LeQcho/WIPTally/S2Mini/COMMENCER-ICI.md

# Tally Atelier 1.7.0 — démarrer ici

Double-cliquer sur **Tally Atelier.app** (Mac), **Lancer-Tally.command** (Terminal Mac) ou **Lancer-Tally.bat** (Windows). Python 3 et Internet sont nécessaires au premier lancement pour installer les dépendances de flash ; les firmwares sont déjà compilés.

## Choisir le profil

- **Master** : S2 Mini, connexion Wi-Fi à l’ATEM. Renseigner le réseau, son mot de passe, l’adresse ATEM et la luminosité de départ.
- **Récepteur** : S2 Mini, choisir le numéro de caméra et les LED. Liaison ESP-NOW au master.
- **Tally Sony** : **LOLIN C3 Mini**, voyant REC autonome en Bluetooth LE pour Sony A7 IV. La S2 Mini n’a pas de Bluetooth et ne convient pas à ce profil.

Renseigner les réglages, brancher une seule carte compatible, puis utiliser **Vérifier la préparation sans flasher** ou le bouton de flash. Le type de puce est vérifié avant écriture. Après vérification, la carte reçoit sa commande de redémarrage automatique. Les profils Sony et ATEM ont des binaires distincts.

Le profil Sony est un **prototype à valider sur caméra**. Voir [SONY.md](SONY.md) pour le câblage GPIO4, l’appairage et les essais REC/STOP. Il indique rouge pour REC confirmé, éteint pour arrêt confirmé, bleu clignotant pour état inconnu ou liaison perdue.

Ce paquet ne contient aucune partition de réglages Wi-Fi personnels. Utiliser l’interface pour préparer les cartes. Les anciens scripts de flash ATEM restent disponibles pour les usages avancés ; sans partition personnelle, ils conservent les réglages NVS existants.

[Guide de l’application](APPLICATION.md) · [Guide ATEM](README.fr.md) · [LED RGB ATEM](LED-RGB.md) · [Sony REC](SONY.md)

Le [bouton de luminosité du master](BOUTON-LUMINOSITE.md) fait passer tous les récepteurs WS2812 entre 25, 50, 75 et 100 %. Pour la mise à jour 1.5, flasher les récepteurs avant le master.

La version **1.7** affiche quatre pages sur l’[OLED SSD1306 du master](ECRAN-OLED.md) : ATEM, Wi-Fi, luminosité et récepteurs actifs. Choisir dans le profil Master une durée de **1 à 120 secondes par page** (5 s par défaut). Flasher aussi chaque récepteur en 1.7 pour le retour de présence et l’extinction de sa LED interne. Les LED externes gardent leurs couleurs et leur réglage de luminosité.
