LeQcho/WIPTally/S2Mini/README.fr.md

# Tally ATEM · Wemos LOLIN S2 Mini

Prototype pour **ESP32-S2 / LOLIN S2 Mini**, avec un master Wi-Fi et des récepteurs ESP-NOW. Les binaires compilés se trouvent dans `firmware/`. Pas besoin de modifier le code pour le premier test.

```text
ATEM ── Ethernet ── Routeur 2,4 GHz ))) Wi-Fi ))) S2 Mini MASTER
                                                  ))) ESP-NOW ))) S2 Mini CAM 1
                                                  ))) ESP-NOW ))) S2 Mini CAM 2…
```

Le master est le seul ESP connecté au routeur et le seul client ATEM. Les récepteurs n'ont besoin ni du mot de passe Wi-Fi ni d'une IP. Le protocole transmet les flags tally fournis par l'ATEM (`TlIn`), ce qui permet de suivre les transitions et les compositions, plutôt que seulement les boutons Program/Preview. Le rouge a priorité si les deux flags sont actifs.

[Imprimer le boîtier V4](../hardware/boitier-tally/README.md) · [Démarrer avec Tally Atelier](COMMENCER-ICI.md)

## Application locale Tally Atelier

Ouvrir **Tally Atelier.app** sur Mac, ou `Lancer-Tally.command` (`Lancer-Tally.bat` sur Windows). L'application permet de saisir le Wi-Fi, l'IP ATEM et le nombre de caméras du master, ou le numéro de caméra et le type de LED du récepteur, avant de flasher en USB. [Guide de l'application](APPLICATION.md).

## Flasher sur Mac

Ouvrir Terminal dans ce dossier `S2Mini`, puis préparer l'outil une seule fois :

```sh
python3 -m venv .flash-venv
.flash-venv/bin/python -m pip install -r requirements-flash.txt
```

Brancher **une seule S2 Mini** avec un câble USB de données. Au besoin, maintenir **0 / BOOT**, appuyer puis relâcher **RST**, puis relâcher **0 / BOOT**. Cela force le mode téléchargement USB.

Pour le master :

```sh
.flash-venv/bin/python flash.py master
```

Débrancher cette carte, brancher une autre S2 Mini, puis :

```sh
.flash-venv/bin/python flash.py receiver
```

Attendre le redémarrage automatique après l’écriture. Si le port USB de la carte ne revient pas, couper puis rétablir son alimentation. Les firmwares démarrent aussi sur batterie ou alimentation USB sans ordinateur.

Si plusieurs ports existent :

```sh
.flash-venv/bin/python flash.py list
.flash-venv/bin/python flash.py receiver --port /dev/cu.usbmodemXXXX
```

Le script vérifie les sommes SHA-256 et cible explicitement **esp32s2**. Il écrit le bootloader à `0x1000`, les partitions à `0x8000`, `boot_app0` à `0xe000` et l'application à `0x10000`. Il conserve la zone NVS de configuration, sauf si un kit personnel fournit `firmware/network-settings.bin` : cette configuration est alors appliquée au master à `0x9000`. Le paquet public ne contient pas ce fichier. Changer de rôle n'efface donc pas les anciens réglages de ce rôle dans le paquet générique. Un flash remplace le firmware précédemment installé sur la carte.

## Premier test sans ATEM

1. Alimenter le master et un récepteur. Le récepteur est **caméra 1** par défaut.
2. Sur téléphone ou Mac, rejoindre le Wi-Fi **Tally-Setup-XX:XX**, mot de passe **tallysetup**. L'absence d'accès Internet est normale.
3. Ouvrir **http://192.168.4.1**, cocher **Mode démo**, puis enregistrer. Aucun SSID / IP n'est requis en démo.
4. Le master simule les caméras 1 et 2. Pour la caméra 1 : 2 s Program, 2 s Preview, 2 s repos, en boucle. La caméra 2 fait l'inverse pour Program et Preview.
5. Vérifier les LED externes ou les messages `PROGRAM`, `PREVIEW` et `IDLE` sur le port série du récepteur à 115200 bauds. Depuis la version 1.7, sa LED interne reste éteinte.
6. Couper le master : le récepteur doit quitter Program/Preview au bout de **1,8 s** et chercher le master ; les WS2812 indiquent la recherche en bleu. Le rallumer : acquisition habituelle en quelques secondes.

## Connexion réelle à l'ATEM

1. Relier l'ATEM en Ethernet au routeur. Vérifier que son IP est accessible depuis le Wi-Fi, par exemple avec ATEM Software Control. Éviter le réseau invité et l'isolation des clients.
2. Sur un master configuré, maintenir **BOOT pendant 2 s après son démarrage** pour rouvrir le Wi-Fi de configuration. Ne pas maintenir BOOT pendant le reset, car cela ouvre le bootloader.
3. Rejoindre Tally-Setup, ouvrir http://192.168.4.1, renseigner le **SSID 2,4 GHz**, le mot de passe et l'IP ATEM. Décocher **Mode démo**, puis enregistrer.
4. Le master redémarre et se connecte au Wi-Fi. Son point d'accès de configuration est fermé lors de ce démarrage normal ; BOOT 2 s permet de le rouvrir.
5. Reconnecter le Mac au routeur. Mettre la caméra 1 en Preview puis en Program sur l'ATEM, tester un Cut et une transition Auto, puis tester une coupure réseau et le retour de connexion.

Le master suit le canal du point d'accès Wi-Fi. Les récepteurs parcourent automatiquement les canaux 1 à 13 lorsqu'ils n'entendent plus le master. Aucun réglage de canal ni appairage MAC n'est requis pour le test. Un canal fixe du routeur rend néanmoins le comportement plus prévisible. Le domaine radio du récepteur est CH (canaux 1–13), à adapter avant utilisation dans une autre région.

## ESP-NOW Long Range

Le master 1.7 inclut un [écran d’information OLED SSD1306 facultatif](ECRAN-OLED.md), avec quatre durées réglables dans Atelier et un compteur de récepteurs actifs. La trame tally 1.5 reste compatible, mais il faut mettre les récepteurs en 1.7 pour leur retour de présence. Leur LED interne est désormais éteinte.

Le master 1.4 configure le débit radio **Long Range à 250 kbit/s** pour les trames ESP-NOW. Sa connexion au routeur utilise les protocoles Wi-Fi habituels. Les récepteurs 1.4 acceptent les trames Long Range et standard sur le canal du master. Si le pilote refuse le débit Long Range, le master tente le débit standard et indique le résultat dans le journal série.

Pour passer d’une version antérieure à 1.4, flasher **les récepteurs d’abord, puis le master**. Les anciens récepteurs ne sont pas prévus pour décoder les trames Long Range du nouveau master. Après la mise à jour, contrôler les messages Long Range au démarrage, puis tester les changements Programme/Preview à la distance d’utilisation. Les compilations et tests hôtes vérifient le logiciel. La portée se mesure sur les cartes en conditions réelles.

[Débits ESP32-S2 documentés par Espressif](https://docs.espressif.com/projects/esp-idf/en/release-v4.4/esp32s2/api-reference/network/esp_wifi.html)

## Deux LED RGB WS2812 5 V

La variante `receiver-rgb` pilote deux WS2812 sur GPIO18 : bleu en recherche, vert en Preview, rouge en Programme. Les détails de câblage, la conversion logique 3,3 → 5 V, les états supplémentaires et la validation sont dans [LED-RGB.md](LED-RGB.md). Tally Atelier permet de choisir la caméra et l’ordre des couleurs du récepteur. La luminosité est transmise par le master, avec un bouton de réglage sur GPIO7. [Guide de luminosité](BOUTON-LUMINOSITE.md).

```sh
.flash-venv/bin/python flash.py receiver-rgb
```

## Numéro de caméra et LED

Le numéro du récepteur correspond à l'entrée caméra ATEM : **1 → entrée 1**, **2 → entrée 2**, jusqu'à **40** selon le mélangeur.

- Pour passer à la caméra suivante : maintenir BOOT **1 s**, puis le relâcher. Une pression longue ne fait avancer que d'une caméra.
- Pour choisir directement : ouvrir le port série à **115200 bauds**, envoyer `cam 2` suivi d'Entrée. Le numéro reste mémorisé après extinction.
- Avec PlatformIO : `pio device monitor -b 115200`, puis saisir la commande. Fermer le moniteur avant de flasher.

| État | LED rouge externe | LED verte externe |
|---|---|---|
| Program | Allumée | Éteinte |
| Preview | Éteinte | Allumée |
| Repos, liaison valide | Éteinte | Éteinte |
| Master présent, ATEM pas prêt | Éteinte | Éteinte |
| Master absent / recherche | Éteinte | Éteinte |

La LED interne GPIO15 des récepteurs 1.7 reste éteinte dans tous ces états.

Sur le **master**, la LED intégrée fixe signifie que les données tally sont prêtes ; elle clignote sinon. Le mode démo est considéré prêt.

Câblage facultatif pour petites LED séparées :

```text
GPIO16 ── résistance 330 Ω ── anode LED rouge ; cathode → GND
GPIO17 ── résistance 330 Ω ── anode LED verte ; cathode → GND
```

Utiliser les numéros GPIO sérigraphiés sur la S2 Mini. Sorties logiques 3,3 V, actives à l'état haut. Pour un ruban WS2812, une LED RGB à anode commune ou une lampe de puissance, il faut adapter la sortie ; ne pas brancher une lampe de puissance directement sur les GPIO.

## Compilation et provenance

```sh
python3 -m pip install platformio==6.1.18
pio run -e master -e receiver -e receiver-rgb -e sony-c3
python3 package_firmware.py
```

Ouvrir ce dossier dans PlatformIO et choisir l'environnement `master` ou `receiver` pour téléverser directement les sources. Plateforme épinglée : **espressif32 6.12.0**, Arduino ESP32 **2.0.17**, cible **lolin_s2_mini**. USB CDC natif activé.

Tests hôtes du protocole radio et de la vraie bibliothèque ATEMbase/ATEMmin avec un transport UDP simulé :

```sh
sh test/run_host_tests.sh
```

Les tests compilent avec AddressSanitizer et UndefinedBehaviorSanitizer. Ils couvrent les paquets perdus, retransmis et désordonnés, les commandes vides (`InCm`), les tailles invalides, le retour du compteur de paquets de 32767 à 0, les reconnexions et les timeouts.

Les sources du portage `S2Mini` sont sous GPL-3.0-or-later ; voir `LICENSE`. Le reste du dépôt amont conserve ses mentions d'origine.

La version `fw=transport-2` corrige la double connexion initiale, consomme entièrement les réponses de handshake, respecte l'ordre des paquets et accuse aussi réception des retransmissions. Un paquet manquant est redemandé par son identifiant exact. Une séquence bloquée est relancée après 5 s ; une session connectée sans tally prêt est relancée après 30 s. Le tally est effacé à chaque nouvelle session et n'est pas annoncé prêt pendant un trou dans la séquence.

`InCm` est reconnu comme marqueur de fin de transfert initial. Une commande de 8 octets sans données est valide et ne provoque plus la suppression des commandes suivantes. La fin d'initialisation par heartbeat est conservée pour les anciens mélangeurs, mais seulement après réception ordonnée des paquets précédents. Références de protocole : [documentation du mainteneur atem-connection](https://atem.julusian.dev/protocol) et [implémentation Sofie](https://github.com/Sofie-Automation/sofie-atem-connection/blob/main/src/lib/atemSocketChild.ts).

Le master écrit toutes les 5 s :

- `STATUS` : version du firmware, Wi-Fi, IP cible, connexion ATEM, initialisation, nombre d'entrées, état prêt.
- `LINK` : signal Wi-Fi, nombre de sessions, paquets/payloads reçus, retransmissions, trous de séquence, paquets malformés, erreurs de commandes et de socket, marqueur `InCm`, dernier ID et âge du dernier contact.
- `queued` indique les envois acceptés par ESP-NOW ; cela ne prouve pas leur réception par un slave. `tx_errors` compte les échecs immédiats d'envoi.

- Fork de [jkowalk/esp-now-atem-tally](https://github.com/jkowalk/esp-now-atem-tally), commit `a249e27ba2c1440b566d36be04cf3faeb8ea2261`. Les dossiers historiques Controller/Receiver sont conservés pour référence ; **utiliser S2Mini pour les nouvelles cartes**. Le nouveau protocole radio n'est pas compatible avec leurs anciens firmwares.
- Les bibliothèques ATEMbase, ATEMmin et SkaarhojPgmspace de `S2Mini/lib` viennent de [AronHetLam/ATEM_tally_light_with_ESP8266](https://github.com/AronHetLam/ATEM_tally_light_with_ESP8266), commit `9aeb2b0931d7b9a70cce16d6f3318f685799068f`, à l'origine de Kasper Skårhøj. Elles sont reprises avec leurs licences et notices.
- [Documentation Wemos S2 Mini](https://www.wemos.cc/en/latest/s2/s2_mini.html).
- [Documentation Espressif ESP-NOW](https://docs.espressif.com/projects/esp-idf/en/v5.5/esp32s2/api-reference/network/esp_now.html) : Wi-Fi et ESP-NOW partagent le canal radio.

## Limites de cette première version

Compilation des deux firmwares et tests hôtes effectués. Une version précédente avait reçu les 8 entrées d’un ATEM Television Studio Pro 4K, puis présenté un blocage de synchronisation. La version `transport-2` a ensuite été flashée et vérifiée sur ce même matériel : `initialized=1`, `tally_inputs=8`, `ready=1`, et changements réels de la caméra 1 entre Preview et Program observés dans le journal USB. Des retransmissions ont été traitées sans blocage pendant cette vérification. La réception ESP-NOW sur une deuxième carte a ensuite été confirmée par son propre journal USB : `Cam1 PREVIEW` puis `Cam1 PROGRAM`, canal 4, `demo=0`. Un redémarrage supplémentaire du master a également retrouvé la synchronisation et les 8 entrées. Aucune mesure de portée ou de latence réelle n'est revendiquée.

Une trame complète est envoyée sur changement d'état (échantillonnage toutes les 20 ms) et au moins toutes les 250 ms. Le broadcast ESP-NOW est non chiffré, sans accusé de réception applicatif. Le récepteur éteint ses sorties si aucune trame valide n'arrive pendant 1,8 s. Une perte de l'ATEM avec le master toujours actif est détectée par la bibliothèque ATEM, après environ 5 s sans paquet, puis signalée aux récepteurs. Ce délai est distinct du timeout ESP-NOW.

Un seul master du même groupe doit être actif à proximité. Pour isoler deux systèmes, changer `kGroup` dans `include/tally.h` des deux firmwares. Un filtre d'adresse MAC du master est disponible dans `src/receiver.cpp` ; il filtre la source mais n'apporte pas de chiffrement. La reprise après changement de canal nécessite un nouveau balayage, soit jusqu'à environ 4 s en conditions favorables, plus les délais de reconnexion Wi-Fi / ATEM.

La bibliothèque fournit jusqu'à 40 index de tally. Les modèles / firmwares qui ne transmettent pas une table `TlIn` compatible nécessiteront une adaptation. Les grandes configurations multi-M/E et les entrées spéciales ne sont pas validées par cette version.
