LeQcho/WIPTally/hardware/boitier-tally/V4/rendus/diffuseur_plat.png

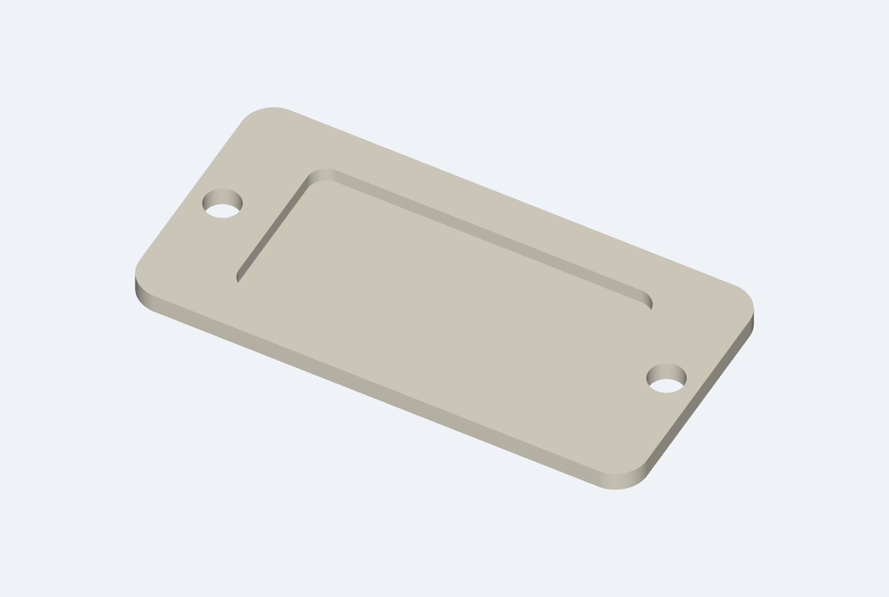
hardware/boitier-tally/V4/rendus/diffuseur_plat.png
