LeQcho/WIPTally/hardware/boitier-tally/V4/rendus/eclate.png

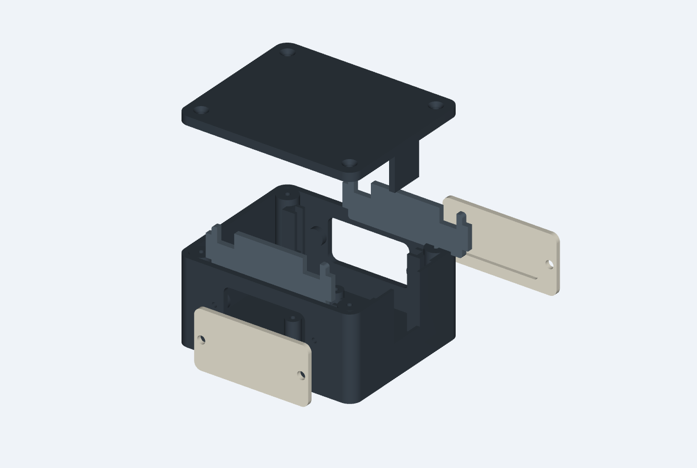
hardware/boitier-tally/V4/rendus/eclate.png
