LeQcho/WIPTally/hardware/boitier-tally/V4/rendus/interieur.png

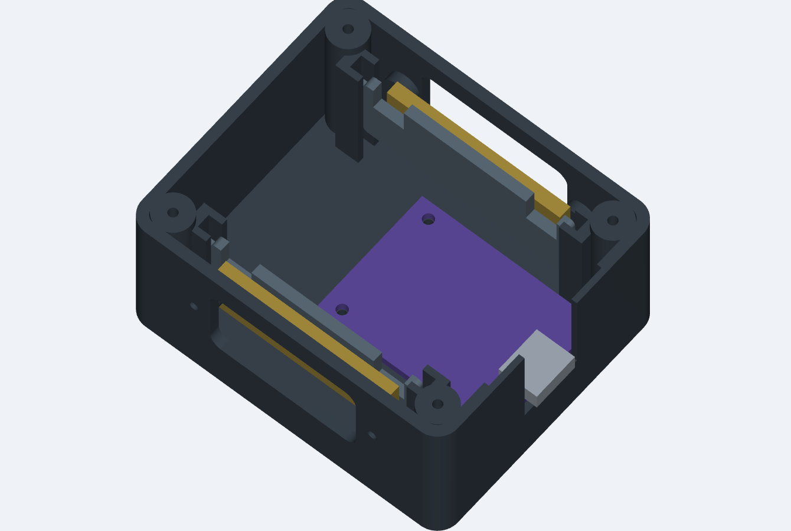
hardware/boitier-tally/V4/rendus/interieur.png
