LeQcho/WIPTally/hardware/boitier-tally/V4/STEP/00_ASSEMBLAGE_reference_6_pieces.step

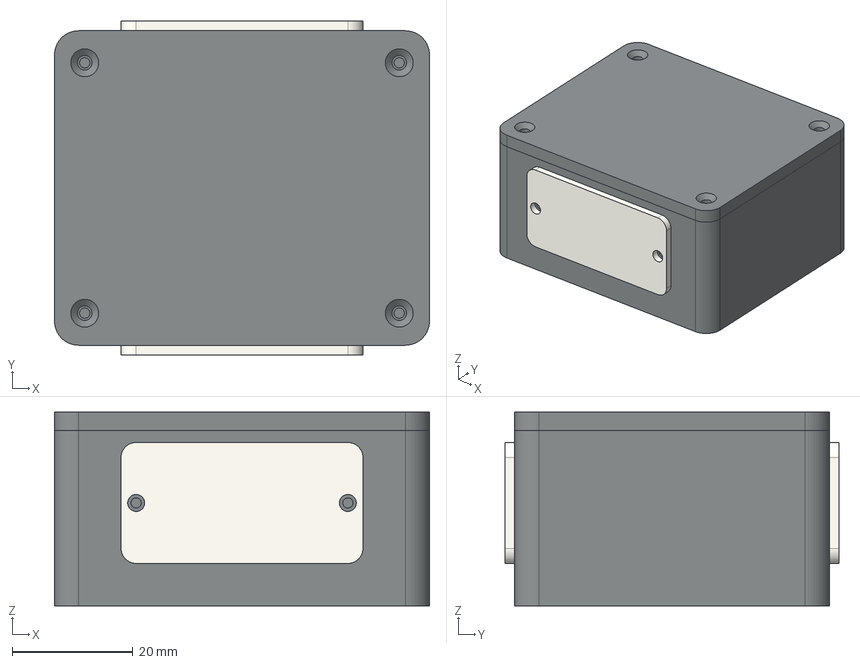
[picture p9: CAD file, 2026-11-09]
hardware/boitier-tally/V4/STEP/00_ASSEMBLAGE_reference_6_pieces.step
62.0 x 55.2 x 32.0 mm
socle
couvercle
support_LED_avant
support_LED_arriere
diffuseur_avant
diffuseur_arriere
