LeQcho/WIPTally/hardware/boitier-tally/V4/acces-boot/Socle-V4-master-acces-BOOT.step

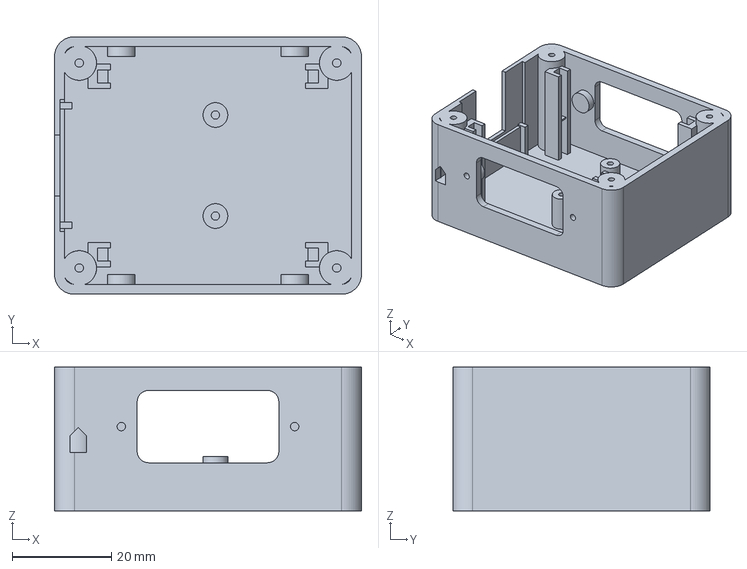
[picture p10: CAD file, 2026-11-10]
hardware/boitier-tally/V4/acces-boot/Socle-V4-master-acces-BOOT.step
62.0 x 52.0 x 29.0 mm
