LeQcho/WIPTally/hardware/boitier-tally/V4/STEP/OPTION_diffuseur_plat_blanc_06mm_x2.step

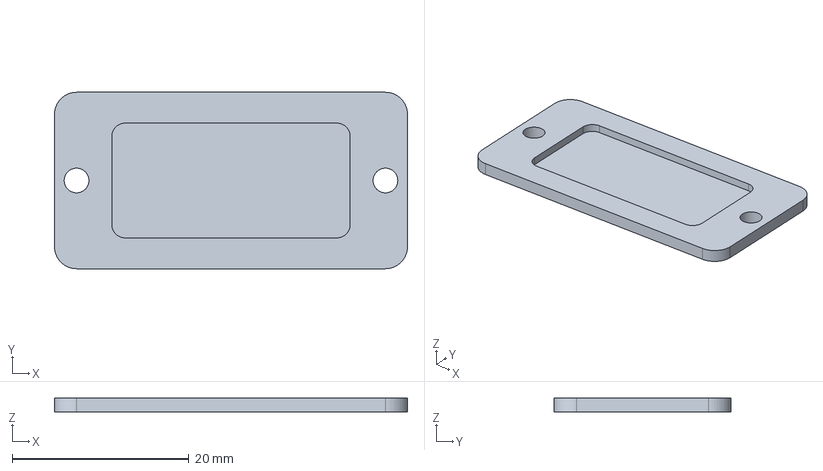
[picture p11: CAD file, 2026-11-09]
hardware/boitier-tally/V4/STEP/OPTION_diffuseur_plat_blanc_06mm_x2.step
40.0 x 20.0 x 1.60 mm
