LeQcho/WIPTally/hardware/boitier-tally/V4/STEP/REFERENCE_electronique_non_imprimable.step

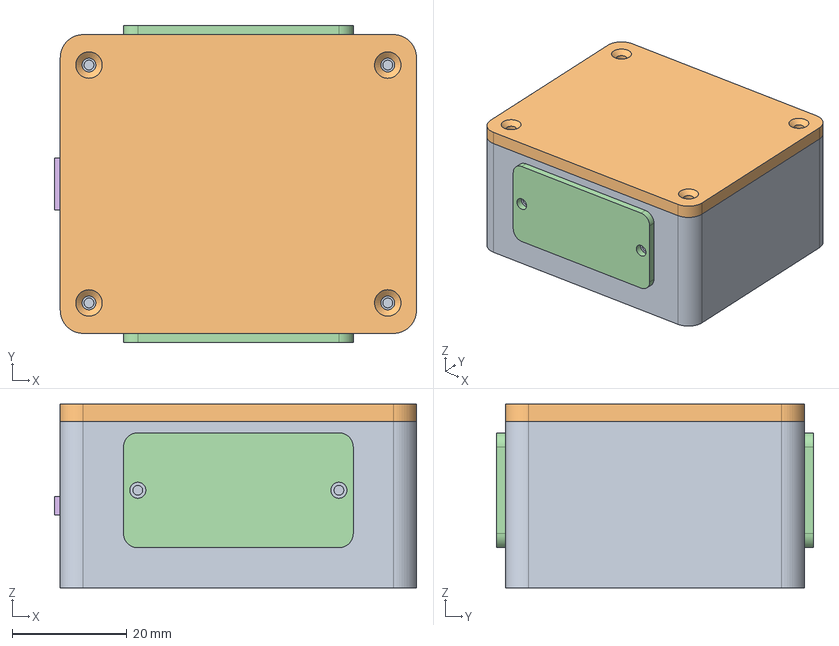
[picture p12: CAD file, 2026-11-09]
hardware/boitier-tally/V4/STEP/REFERENCE_electronique_non_imprimable.step
63.0 x 55.2 x 32.0 mm
socle
couvercle
support_LED_avant
support_LED_arriere
diffuseur_avant
diffuseur_arriere
carte_nominale
USB_nominal
ruban_LED_avant_nominal
ruban_LED_arriere_nominal
