LeQcho/WIPTally/hardware/boitier-tally/V4/STEP/TEST_fenetre_et_vis_diffuseur.step

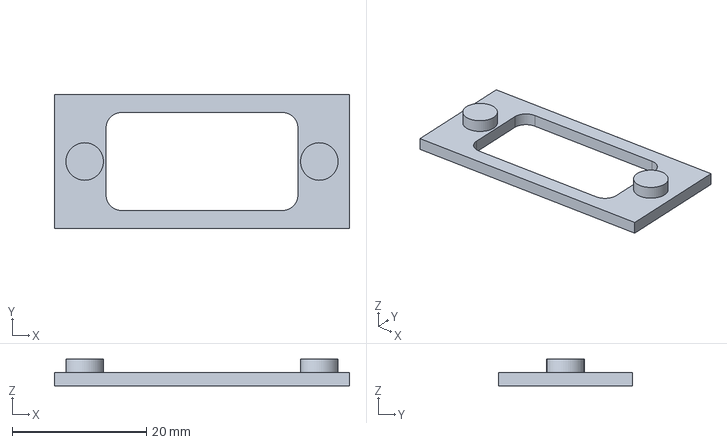
[picture p13: CAD file, 2026-11-09]
hardware/boitier-tally/V4/STEP/TEST_fenetre_et_vis_diffuseur.step
44.0 x 20.0 x 4.00 mm
