LeQcho/WIPTally/hardware/boitier-tally/V4/STEP/TEST_fixation_ESP_et_USB.step

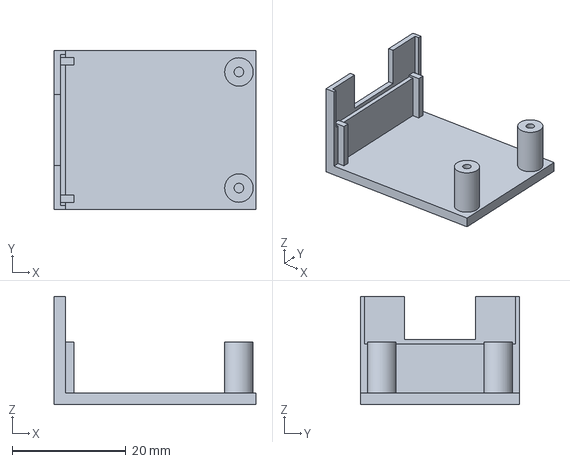
[picture p14: CAD file, 2026-11-09]
hardware/boitier-tally/V4/STEP/TEST_fixation_ESP_et_USB.step
35.5 x 28.0 x 19.0 mm
