LeQcho/WIPTally/hardware/boitier-tally/V4/STEP/TEST_glissiere_LED.step

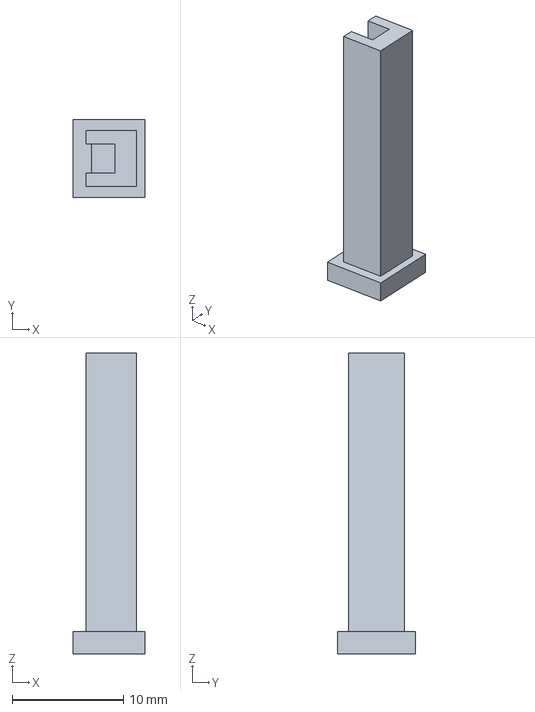
[picture p15: CAD file, 2026-11-09]
hardware/boitier-tally/V4/STEP/TEST_glissiere_LED.step
6.50 x 7.00 x 27.0 mm
