LeQcho/WIPTally/hardware/boitier-tally/V4/STEP/02_couvercle_noir_4_vis.step

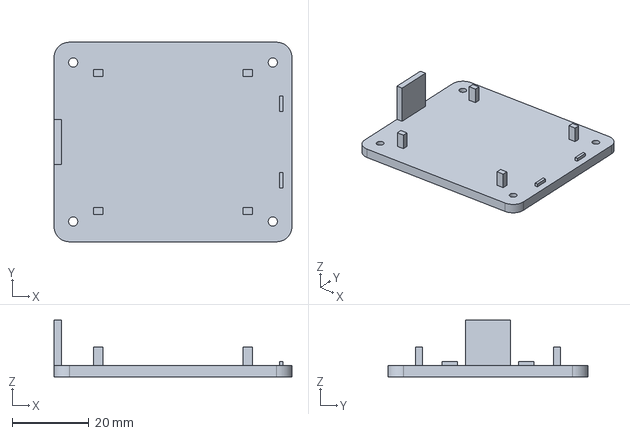
[picture p16: CAD file, 2026-11-09]
hardware/boitier-tally/V4/STEP/02_couvercle_noir_4_vis.step
62.0 x 52.0 x 14.8 mm
