LeQcho/WIPTally/hardware/boitier-tally/V4/STEP/03_support_LED_x2.step

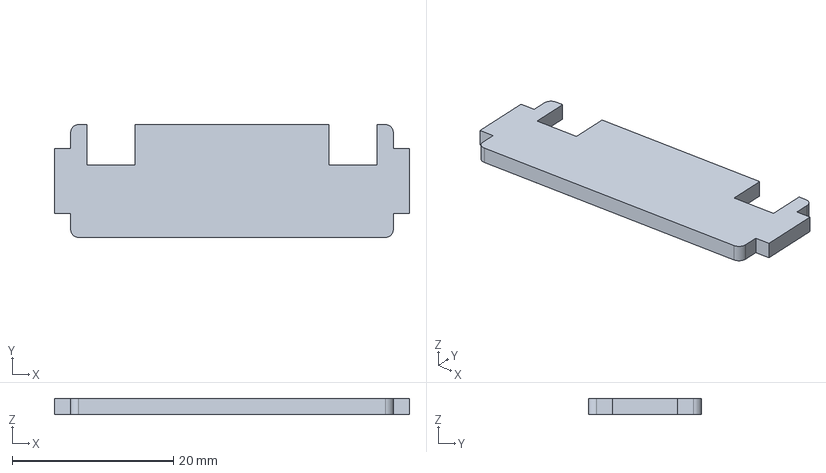
[picture p17: CAD file, 2026-11-09]
hardware/boitier-tally/V4/STEP/03_support_LED_x2.step
44.0 x 14.0 x 2.00 mm
