LeQcho/WIPTally/(list of files, cad)

Other CAD files:
hardware/boitier-tally/V4/STEP/01_socle_noir_4_vis.step
hardware/boitier-tally/V4/STEP/04_diffuseur_plat_blanc_04mm_x2.step
hardware/boitier-tally/V4/STL/01_socle_noir_4_vis.stl
hardware/boitier-tally/V4/STL/02_couvercle_noir_4_vis.stl
hardware/boitier-tally/V4/STL/03_support_LED_x2.stl
hardware/boitier-tally/V4/STL/04_diffuseur_plat_blanc_04mm_x2.stl
hardware/boitier-tally/V4/STL/OPTION_diffuseur_plat_blanc_06mm_x2.stl
hardware/boitier-tally/V4/STL/TEST_fenetre_et_vis_diffuseur.stl
hardware/boitier-tally/V4/STL/TEST_fixation_ESP_et_USB.stl
hardware/boitier-tally/V4/STL/TEST_glissiere_LED.stl
hardware/boitier-tally/V4/acces-boot/Socle-V4-master-acces-BOOT.stl
