LeQcho/WIPTally/(commit log)

2026-11-09 Publish Tally Atelier 1.3 and the V4 enclosure
    Update the S2 Mini ATEM firmware and desktop flash app, and include the experimental C3 Sony REC profile. Document setup and wiring, add V4 CAD and print files, and illustrate assembly with new renders.
    [00_ASSEMBLAGE_reference_6_pieces.step, 01_socle_noir_4_vis.step, 01_socle_noir_4_vis.stl, 02_couvercle_noir_4_vis.step, 02_couvercle_noir_4_vis.stl, 03_support_LED_x2.step, 03_support_LED_x2.stl, 04_diffuseur_plat_blanc_04mm_x2.step]
2026-11-09 Restart USB boards as part of flashing
    Trigger the watchdog reset in the same esptool session, recognize an S2 Mini after USB port renumbering, and offer an unplug/replug fallback after verified writes. Share the behavior between Atelier and the direct launchers.
    [backend.py, flash.py, server.py, test_desktop.py, test_sony.py, usb_flash.py]
2026-11-10 Add a V4 master base with side access to BOOT
    Provide a small printed passage for the side-actuated LOLIN S2 Mini BOOT switch, plus STEP, STL and mounting guidance.
    [Socle-V4-master-acces-BOOT.step, Socle-V4-master-acces-BOOT.stl]
2026-11-11 Control receiver brightness from the master button
    Cycle four brightness levels with a debounced GPIO7 button, persist the level on the master, and broadcast it in version 2 tally frames. Move the initial brightness control to the Master form in Atelier 1.5 and include updated firmware and wiring guidance.
2026-11-11 Add per-page OLED timing and receiver presence; turn off receiver internal LEDs
